customMK/Bonsai-C/C4 compact JLCPCB/Bonsai_C4.kicad_pcb

## KiCad design C4 compact JLCPCB/Bonsai_C4.kicad_pcb (2025-04-04)

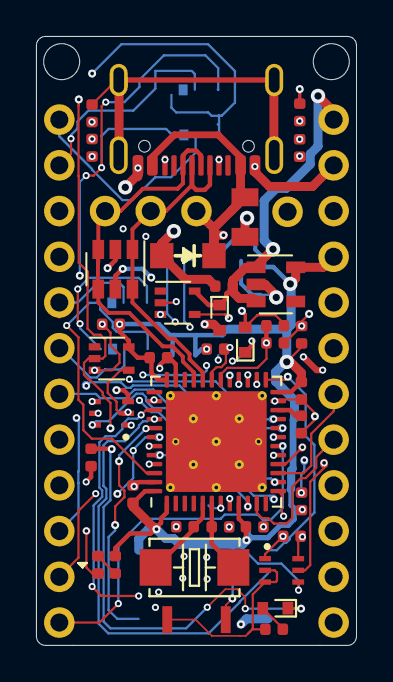
[picture p1: board Bonsai_C4.kicad_pcb from above]

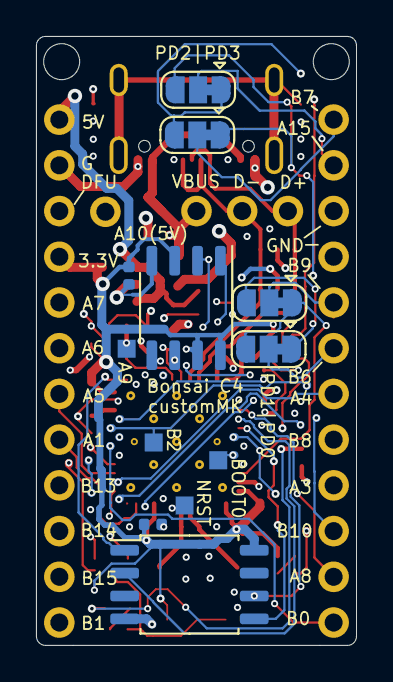
[picture p2: board Bonsai_C4.kicad_pcb from below]

Board: 4 copper layers, 17.8 x 33.8 mm, 56 parts (12 on the bottom side), 54 nets.

Parts:
C1, C2, C3, C4, C5, C7, C13: cap_100nF_16v_0402; C_0402_1005Metric
C6, C14: cap_4.7uF_10v_0402; C_0402_1005Metric
C8, C9: cap_20pF_50v_0402; C_0402_1005Metric
C10, C11: cap_1uF_10v_0402; C_0402_1005Metric
C12: cap_10uF_10v_0402; C_0402_1005Metric
D1, D5: PMEG2010AEB; D_SOD-523
D2: 1N4148; D_SOD-523
D3: SMD-LED-WHITE_0402_; LED_0402
D4: SMF5.0A; D_SOD-123FL
F1: SMD-PPTC-500MA_0805_; F0805
FB1: fb_0402_26ohm; R_0402_1005Metric
J1: HEADER-VERT_3P-2.54_; PinHeader_1x03_P2.54mm_Vertical
J2: HEADER-VERT_1P-2.54_; PinHeader_1x01_P2.54mm_Vertical
J3: MC-311D
J4, J5: HEADER-VERT_12P-2.54_; PinHeader_1x12_P2.54mm_Vertical
J8, J14, J15, J16: PAD_SQUARE_1MM
JP1, JP2, JP3, JP4: SolderJumper_3_Bridged12; SolderJumper-3_P1.3mm_Bridged12_RoundedPad1.0x1.5mm
K1: SMD-SWITCH-TACTILE-SPST-NO_2P-2.0MMx3.5MM_; SW2-SMD-2.0X3.5X0.45MM
MH1, MH2: 2mm_mounting_hole; MountingHole_2mm
Q1, Q2: MUN5311DW1T1G; SOT-363_SC-70-6_SC-88
R1, R8: r_100k_0402_1p; R_0402_1005Metric
R2, R3: r_5.1k_0402_1p; R_0402_1005Metric
R4, R7: r_75_0402_1p; R_0402_1005Metric
R5: r_4.7k_0402_1p; R_0402_1005Metric
R6: r_10k_0402_1p; R_0402_1005Metric
R9: r_470_0402_1p; R_0402_1005Metric
U1: AAP2967-33VIR1; SOT-23-5
U2: SRV05-4; SOT-23-6
U3: STM32F411CEU6; QFN-48-1EP_7x7mm_P0.5mm_EP5.6x5.6mm_ThermalVias
U4, U5: SN74LV1T34DCKR; SOT-353_SC-70-5
U6: W25Q128JVSIQ; SOIC-8_5.23x5.23mm_P1.27mm
U7: MB85RS64PNF-G-JNERE1; SOP-8_3.9x4.9mm_P1.27mm
Y1: SMD-CRYSTAL-8MHZ-20PF-10PPM_2P-5.0X3.2MM_; X2-SMD-5.0X3.2X1.3MM

Connections:
+3V3: C1.1, C2.1, C3.1, C4.1, C5.1, C6.1, C11.1, C13.1, J5.4, K1.4, Q1.4, R4.1, R8.1, U1.5, U3.1, U3.9, U3.24, U3.36, U3.48, U5.5, U6.8, U7.3, U7.7, U7.8
+5V: C10.1, D1.1, J5.1, U1.1, U1.3, U4.5
/A0_FRAM_CS: U3.10, U7.1
/A1: J5.8, U3.11
/A3: J4.9, U3.13
/A4: J4.7, U3.14
/A5: J5.7, U3.15
/A6: J5.6, U3.16
/A7: J5.5, U3.17
/A8: J4.11, U3.29
/A10: R8.2, U3.31, U4.2
/A10_5V: J2.1, U4.4
/A15: JP1.1, JP2.3, U3.38
/B0: J4.12, U3.18
/B1: J5.12, U3.19
/B2: J14.1, Q2.5, R9.2, U3.20
/B3_SCK: U3.39, U6.6, U7.6
/B4_MISO: U3.40, U6.2, U7.2
/B5_MOSI: U3.41, U6.5, U7.5
/B6: JP3.3, JP4.1, U3.42
/B7: JP1.3, JP2.1, U3.43
/B8: J4.8, U3.45
/B9: JP3.1, JP4.3, U3.46
/B10: J4.10, U3.21
/B12_FLASH_CS: U3.25, U6.1
/B13: J5.9, U3.26
/B14: J5.10, U3.27
/B15: J5.11, U3.28
/BOOT0: J15.1, Q2.2, U3.44, U5.4
/D+: J1.3, J3.A6, J3.B6, U2.3, U2.4, U3.33
/D-: J1.2, J3.A7, J3.B7, U2.1, U2.6, U3.32
/DFU: J5.3, Q1.5
/F0: C8.1, U3.5, Y1.1
/F1: C9.1, U3.6, Y1.2
/NRST: C7.1, J16.1, Q1.6, U3.7
/PD0: J4.6, JP4.2
/PD1: J4.5, JP3.2
/PD2: J4.2, JP1.2
/PD3: J4.1, JP2.2
/SwitchPin: K1.2, Q1.2, Q1.3, R7.1
/VBUS_DET: J8.1, R5.2, R6.1, U3.30
/VCAP_1: C14.1, U3.22
GND: C1.2, C2.2, C3.2, C4.2, C5.2, C6.2, C7.2, C8.2, C9.2, C10.2, C11.2, C12.2, C13.2, C14.2, D4.2, FB1.2, J3.A1, J3.B1, J4.3, J4.4, J5.2, Q1.1, Q2.1, Q2.3, R1.2, R2.2, R3.1, R6.2, U1.2, U2.2, U3.8, U3.23, U3.35, U3.47, U3.49, U4.3, U5.3, U6.4, U7.4
unnamed: C12.1, D2.-, R1.1, U5.2
unnamed: D1.2, F1.1
unnamed: D2.+, R7.2
unnamed: D3.+, R4.2
unnamed: D3.-, Q2.4
unnamed: D5.1, U2.5
unnamed: FB1.1, J3.S
unnamed: J3.A5, R2.1
unnamed: J3.B5, R3.2
unnamed: Q2.6, R9.1
VBUS: D4.1, D5.2, F1.2, J1.1, J3.A4, J3.B4, R5.1
