customMK/Bonsai-C/C3/Bonsai_C.kicad_pcb

## KiCad design C3/Bonsai_C.kicad_pcb (2023-07-08)

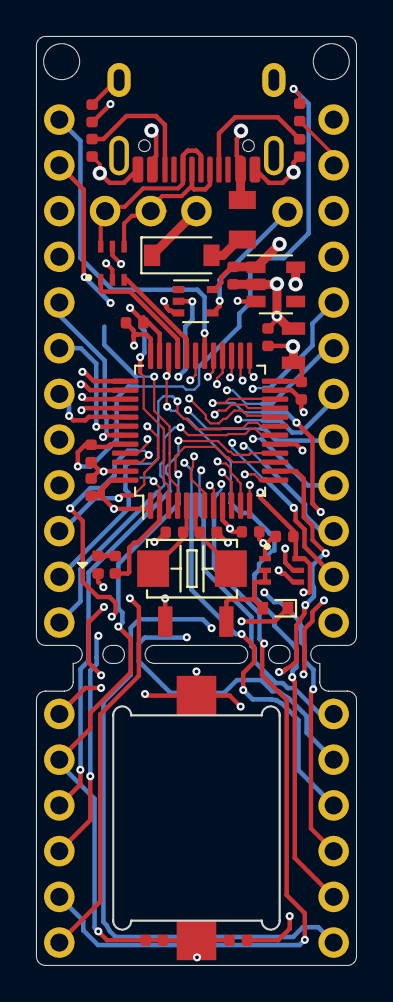
[picture p3: board Bonsai_C.kicad_pcb from above]

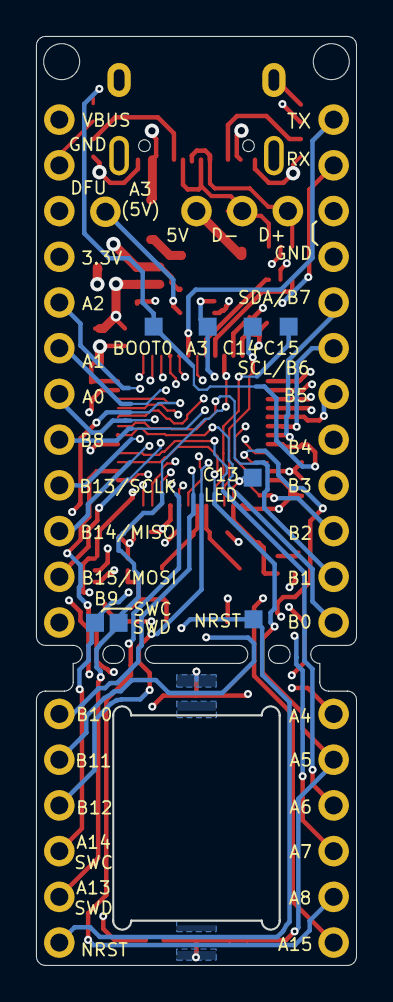
[picture p4: board Bonsai_C.kicad_pcb from below]

Board: 4 copper layers, 17.8 x 51.6 mm, 47 parts (8 on the bottom side), 53 nets.

Parts:
BZ1: Buzzer_Mallory; Buzzer_Mallory_AST1109MLTRQ
C1, C2, C3, C4, C7: cap_100nF_16v_0402; C_0402_1005Metric
C6: cap_4.7uF_25v_0805; C_0805
C8, C9: cap_20pF_50v_0402; C_0402_1005Metric
C10, C11: cap_1uF_10v_0402; C_0402_1005Metric
C12: cap_10uF_6v_0402; C_0402_1005Metric
D1: B5819W; D_SOD-123
D2: 1N4148; D_SOD-523
D3: SMD-LED-WHITE_0402_; LED_0402
F1: SMD-PPTC-500MA_0805_; F0805
FB1: fb_0402_26ohm; R_0402_1005Metric
J1: HEADER-VERT_3P-2.54_; PinHeader_1x03_P2.54mm_Vertical
J2: HEADER-VERT_1P-2.54_; PinHeader_1x01_P2.54mm_Vertical
J3: TYPE-C-31-M12_13; TYPE-C-31-M-12
J4, J5: HEADER-VERT_12P-2.54_; PinHeader_1x12_P2.54mm_Vertical
J6, J7: HEADER-VERT_6P-2.54_; PinHeader_1x06_P2.54mm_Vertical
J8, J9, J10, J11, J12, J14, J15, J16: PAD_SQUARE_1MM
K1: SMD-SWITCH-TACTILE-SPST-NO_2P-2.5MMx3.0MM_; SW2-SMD-2.5X3.0X1.6MM
MH1, MH2: 2mm_mounting_hole; MountingHole_2mm
Q1: MUN5311DW1T1G; SOT-363_SC-70-6_SC-88
R1: r_100k_0402_1p; R_0402_1005Metric
R2, R3: r_5.1k_0402_1p; R_0402_1005Metric
R4: r_75_0402_1p; R_0402_1005Metric
R5, R6: r_0_0402_nopop; R_0402_1005Metric
U1: AAP2967-33VIR1; SOT-23-5
U2: NUF2221W1T2G; SOT-363_SC-70-6_SC-88
U3: STM32F303CCT6; LQFP-48_7x7mm_P0.5mm
U4: SN74LV1T34DCKR; SOT-353_SC-70-5
Y1: SMD-CRYSTAL-8MHZ-20PF-10PPM_2P-5.0X3.2MM_; X2-SMD-5.0X3.2X1.3MM

Connections:
+3V3: C1.1, C2.1, C3.1, C4.1, C6.1, C11.1, J5.4, K1.1, Q1.4, U1.5, U3.1, U3.9, U3.24, U3.36, U3.48
+5V: C10.1, D1.1, J1.1, U1.1, U1.3, U4.5
/A0: J5.7, U3.10
/A1: J5.6, U3.11
/A2: J5.5, U3.12
/A3: J14.1, U3.13, U4.2
/A3_5V: J2.1, U4.4
/A4: BZ1.2, J7.1, U3.14
/A5: BZ1.1, J7.2, R5.1, R5.2, R6.1, U3.15
/A6: J7.3, U3.16
/A7: J7.4, U3.17
/A8: J7.5, U3.29
/A9: J4.1, U3.30
/A10: J4.2, U3.31
/A11: U2.3, U3.32
/A12: U2.1, U3.33
/A13: J6.5, J11.1, U3.34
/A14: J6.4, J9.1, U3.37
/A15: J7.6, U3.38
/B0: J4.12, U3.18
/B1: J4.11, U3.19
/B2: J4.10, U3.20
/B3: J4.9, U3.39
/B4: J4.8, U3.40
/B5: J4.7, U3.41
/B6: J4.6, U3.42
/B7: J4.5, U3.43
/B8: J5.8, U3.45
/B9: J5.12, U3.46
/B10: J6.1, U3.21
/B11: J6.2, U3.22
/B12: J6.3, U3.25
/B13: J5.9, U3.26
/B14: J5.10, U3.27
/B15: J5.11, U3.28
/BOOT0: C12.1, D2.-, J15.1, R1.1, U3.44
/C13: J8.1, R4.2, U3.2
/C14: J10.1, U3.3
/C15: J12.1, U3.4
/D+: J1.3, J3.A6, J3.B6, U2.6
/D-: J1.2, J3.A7, J3.B7, U2.4
/DFU: J5.3, Q1.5
/F0: C8.1, U3.5, Y1.1
/F1: C9.1, U3.6, Y1.2
/NRST: C7.1, J6.6, J16.1, Q1.6, U3.7
/SwitchPin: D2.+, K1.2, Q1.2, Q1.3
GND: C1.2, C2.2, C3.2, C4.2, C6.2, C7.2, C8.2, C9.2, C10.2, C11.2, C12.2, D3.-, FB1.2, J3.A1, J3.B1, J4.3, J4.4, J5.2, Q1.1, R1.2, R2.2, R3.1, R6.2, U1.2, U2.2, U3.8, U3.23, U3.35, U3.47, U4.3
unnamed: D1.2, F1.2
unnamed: D3.+, R4.1
unnamed: FB1.1, J3.S
unnamed: J3.A5, R2.1
unnamed: J3.B5, R3.2
VBUS: F1.1, J3.A4, J3.B4, J5.1, U2.5
